gopalchand/i2c_leader_and_followers/Arduino_i2c_Leader_rev6/Arduino_i2c_Leader_rev6.pdf

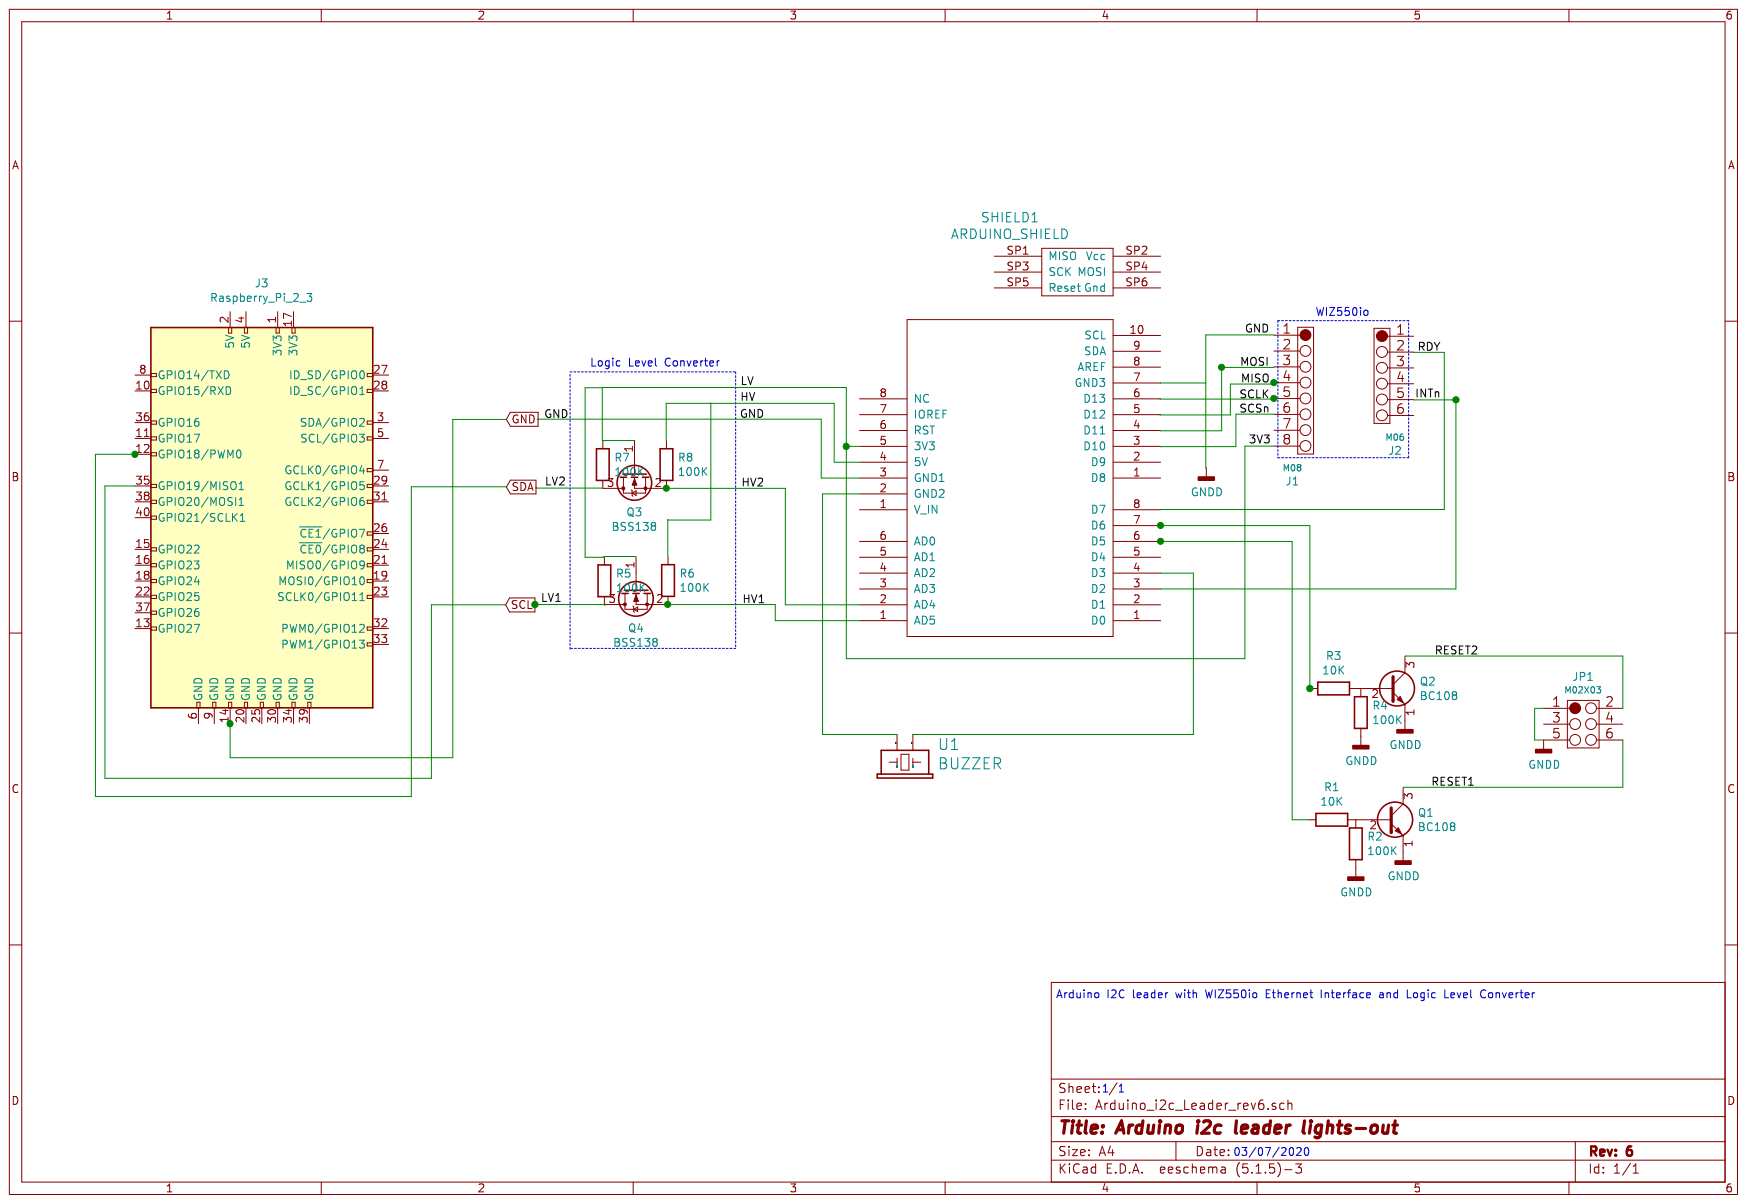
[picture p1: page 1]
