gopalchand/i2c_leader_and_followers/Arduino_i2c_Leader_rev6/Arduino_i2c_Leader_rev6.sch

## KiCad design Arduino_i2c_Leader_rev6/Arduino_i2c_Leader_rev6.sch (2020-07-03)

Schematic: Arduino_i2c_Leader_rev6.sch

Parts:
J1: M08; PinHeader_1x08_P2.54mm_Vertical
J2: M06; PinHeader_1x06_P2.54mm_Vertical
J3: Raspberry_Pi_2_3
JP1: M02X03
Q1, Q2: BC108; TO-11-3
Q3, Q4: BSS138; SOT-23
R1, R3: 10K; R_Axial_DIN0207_L6.3mm_D2.5mm_P10.16mm_Horizontal
R2, R4: 100K; R_Axial_DIN0207_L6.3mm_D2.5mm_P10.16mm_Horizontal
R5, R6, R7, R8: 100K; R_0805_2012Metric
SHIELD1: ARDUINO_SHIELD
U1: BUZZER; Buzzer_D14mm_H7mm_P10mm

Notes on the sheet:
Logic Level Converter
03/07/2020
WIZ550io
Arduino I2C leader with WIZ550io Ethernet Interface and Logic Level Converter
