gopalchand/i2c_leader_and_followers/(commit log)

2020-03-15 Add files via upload
    Arduino code for master.
    Talking to slave at address 0x22.
    Also code to reset Raspberry Pi and Ubuntu systems using pins 5 and 6 to control. Pin 3 has piezo buzzer to identify system being rebooted.
2020-03-15 Add files via upload
    Ubuntu FTDI slave code using FT201XB-WE USB device from FTDI. Placed in examples folder of D2XX distribution (x64 or x32). Makefile required for creating heartbeat_i2c.
2020-07-03 Added PDF of schematic
2020-07-19 deleted: i2c_leader_arduino/i2c_leader.ino
2021-11-09 Update README.md
    https://forum.kicad.info/t/warning-avoid-all-links-to-kicad-pcb-org-use-kicad-org/31521
